ansue1234/DDPKey/README.md

# DDPKey
code for a key accessory that helps reduce incidents of drunk driving
