ansue1234/DDPKey/DDPKeyCode/DDPKey/DDPKey_schem.png

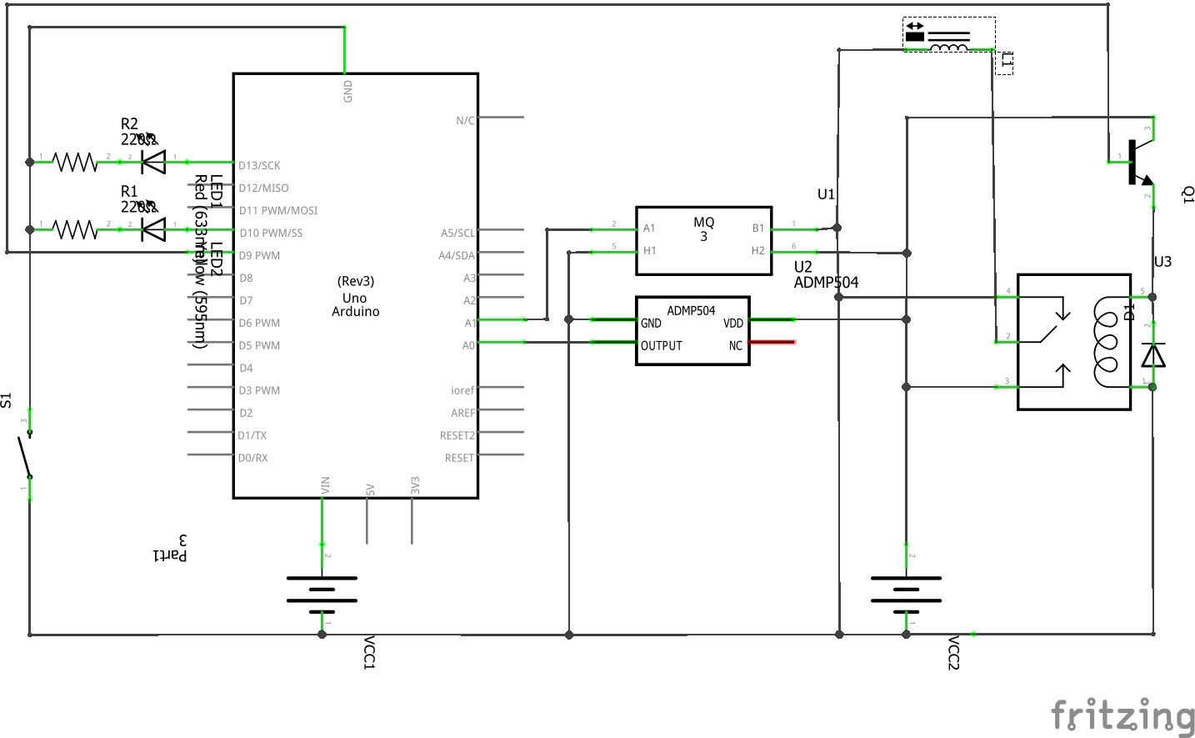
DDPKeyCode/DDPKey/DDPKey_schem.png
