ansue1234/DDPKey/Schematics/Schematics.png

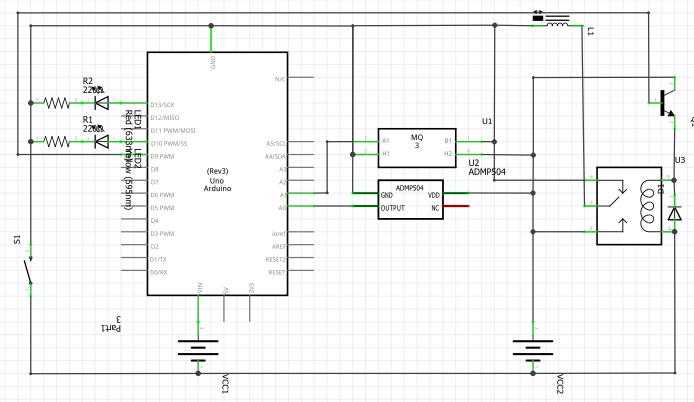
Schematics/Schematics.png
