ansue1234/DDPKey/(list of files, drawings)

Other design files:
DDPKeyCode/DDPKey/DDPKey.fzz
