ansue1234/DDPKey/(commit log)

2018-03-03 failed attempt at configuring the ATMega
    [DDPKey.ino]
2018-03-17 Schematics up
    [DDPKey.fzz]
2018-03-18 have final Schematics
    [DDPKey.fzz]
